m3-learning/Pulsed-Laser-Deposition-Multi-Target-Carousel-Controller/3d_models/Custom backplate/REAME.md

This custom panel replaces the back plate on the multi-target carousel controller.
