m3-learning/Pulsed-Laser-Deposition-Multi-Target-Carousel-Controller/3d_models/Custom backplate/Panel Weld Mount.pdf

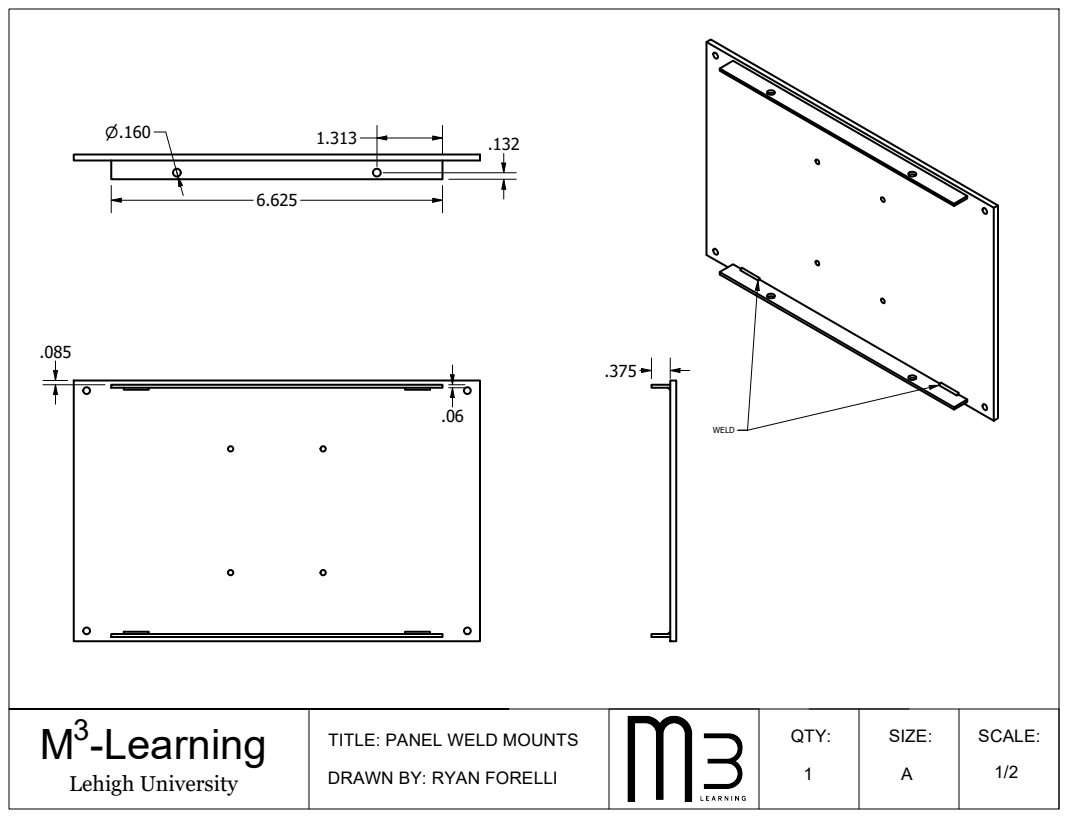
[picture p2: page 1]
Lehigh University

TITLE: PANEL WELD MOUNTS

DRAWN BY: RYAN FORELLI
