m3-learning/Pulsed-Laser-Deposition-Multi-Target-Carousel-Controller/schematics/PLD_Controller_Board/PLD Controller Board.brd

## EAGLE design schematics/PLD_Controller_Board/PLD Controller Board.brd (2021-06-27)

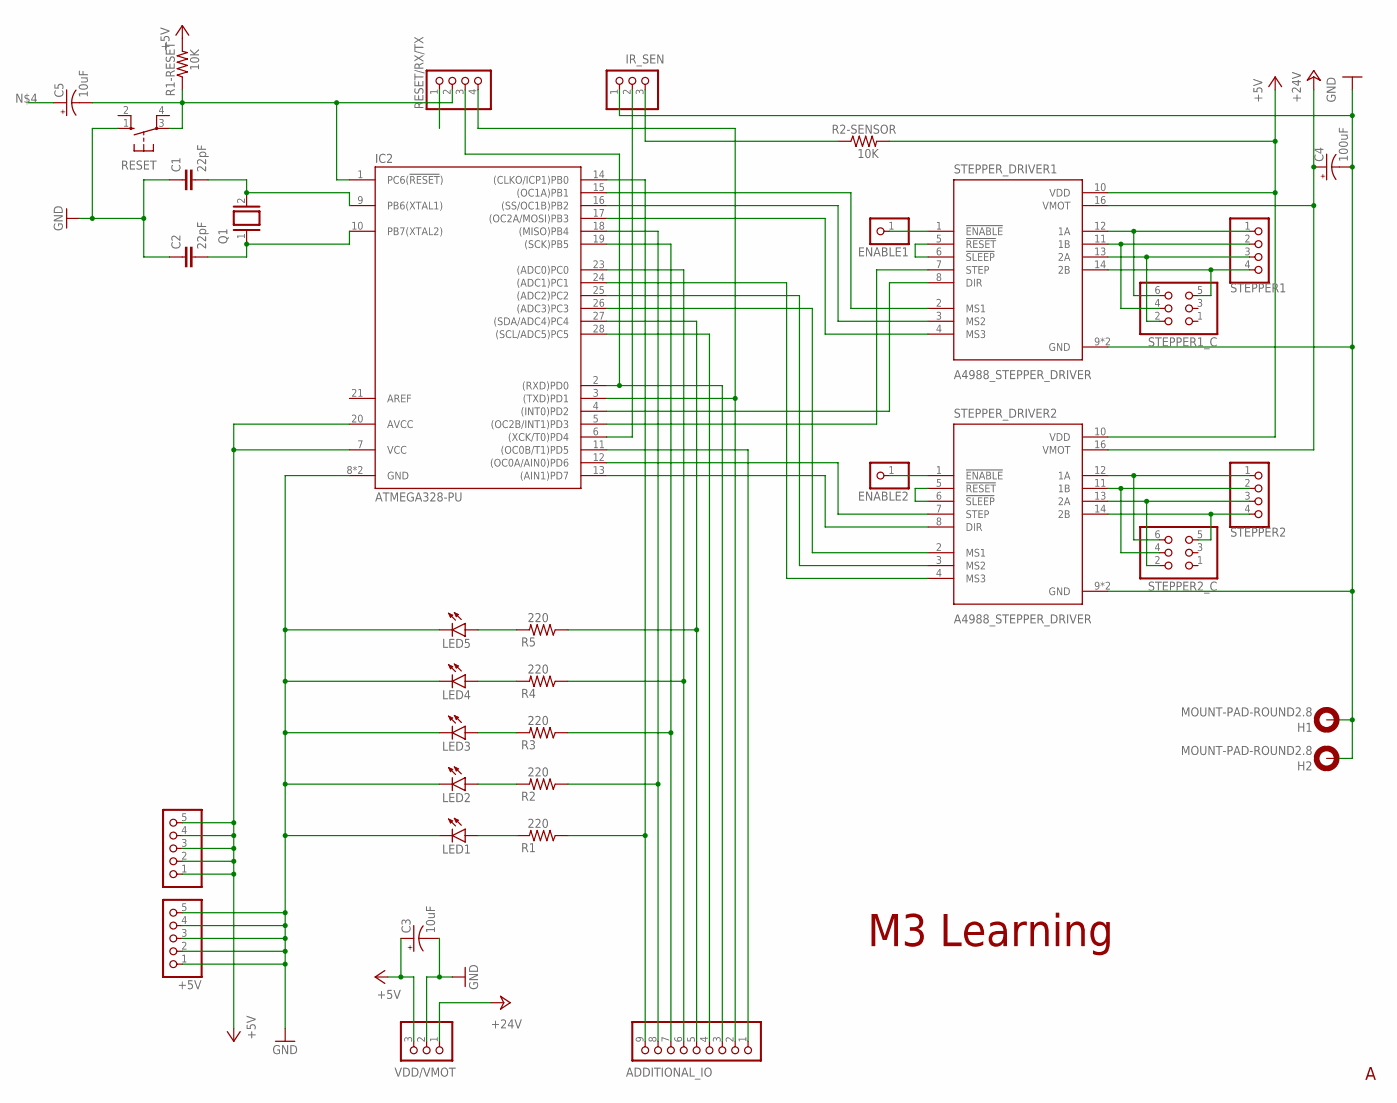
[picture p3: schematic PLD Controller Board.sch]

Parts:
+5V: PINHD-1X5; 1X05
ADDITIONAL_IO: PINHD-1X9; 1X09
C1, C2: 22pF; CAP-PTH-2.54
C3, C5: 10uF; CPOL-RADIAL-2.5MM-5MM
C4: 100uF; CPOL-RADIAL-2.5MM-5MM
ENABLE1, ENABLE2: PINHD-1X1; 1X01
GND: PINHD-1X5; 1X05
H1, H2: MOUNT-PAD-ROUND2.8; 2,8-PAD
IC2: ATMEGA328-PU; DIL28
IR_SEN: PINHD-1X3; 1X03
LED1, LED2, LED3, LED4, LED5: LED5MM
Q1: XTAL/S; QS
R1, R2, R3, R4, R5: 220; 0204/7
R1-RESET, R2-SENSOR: 10K; 0204/7
RESET: 10-XX; B3F-10XX
RESET/RX/TX: PINHD-1X4; 1X04
STEPPER1, STEPPER2: PINHD-1X4; 1X04
STEPPER1_C, STEPPER2_C: PINHD-2X3; 2X03
STEPPER_DRIVER1, STEPPER_DRIVER2: A4988_STEPPER_DRIVER; MODULE_A4988_STEPPER_MOTOR_DRIVER_CARRIER
VDD/VMOT: PINHD-1X3; 1X03

Connections:
+5V: C3.1 (+), GND.1, GND.2, GND.3, GND.4, GND.5, IC2.7 (VCC), IC2.20 (AVCC), R1-RESET.2, R2-SENSOR.2, STEPPER_DRIVER1.10 (VDD), STEPPER_DRIVER2.10 (VDD), VDD/VMOT.3
+24V: C4.1 (+), STEPPER_DRIVER1.16 (VMOT), STEPPER_DRIVER2.16 (VMOT), VDD/VMOT.1
GND: +5V.1, +5V.2, +5V.3, +5V.4, +5V.5, C1.1, C2.1, C3.2 (-), C4.2 (-), H1.B2,8, H2.B2,8, IC2.8 (GND), IC2.22 (GND), IR_SEN.1, LED1.K (C), LED2.K (C), LED3.K (C), LED4.K (C), LED5.K (C), RESET.1 (S), STEPPER_DRIVER1.9 (GND), STEPPER_DRIVER1.15 (GND), STEPPER_DRIVER2.9 (GND), STEPPER_DRIVER2.15 (GND), VDD/VMOT.2
unnamed: C5.2 (-), IC2.1 (PC6(!RESET!)), R1-RESET.1, RESET.3, RESET/RX/TX.2
unnamed: C1.2, IC2.9 (PB6(XTAL1)), Q1.2
unnamed: C2.2, IC2.10 (PB7(XTAL2)), Q1.1
unnamed: C5.1 (+), RESET/RX/TX.1
unnamed: STEPPER_DRIVER1.5 (!RESET), STEPPER_DRIVER1.6 (!SLEEP)
unnamed: STEPPER_DRIVER2.5 (!RESET), STEPPER_DRIVER2.6 (!SLEEP)
unnamed: IR_SEN.3, R2-SENSOR.1
unnamed: STEPPER1.2, STEPPER1_C.4, STEPPER_DRIVER1.11 (1B)
unnamed: STEPPER1.3, STEPPER1_C.2, STEPPER_DRIVER1.13 (2A)
unnamed: STEPPER1.4, STEPPER1_C.5, STEPPER_DRIVER1.14 (2B)
unnamed: STEPPER2.1, STEPPER2_C.6, STEPPER_DRIVER2.12 (1A)
unnamed: STEPPER2.2, STEPPER2_C.4, STEPPER_DRIVER2.11 (1B)
unnamed: STEPPER2.3, STEPPER2_C.2, STEPPER_DRIVER2.13 (2A)
unnamed: STEPPER2.4, STEPPER2_C.5, STEPPER_DRIVER2.14 (2B)
unnamed: ENABLE1.1, STEPPER_DRIVER1.1 (!ENABLE)
unnamed: ENABLE2.1, STEPPER_DRIVER2.1 (!ENABLE)
unnamed: LED4.A, R4.2
unnamed: LED3.A, R3.2
unnamed: LED2.A, R2.2
unnamed: LED1.A, R1.2
unnamed: IC2.4 ((INT0)PD2), STEPPER_DRIVER1.8 (DIR)
unnamed: IC2.5 ((OC2B/INT1)PD3), STEPPER_DRIVER1.7 (STEP)
unnamed: IC2.13 ((AIN1)PD7), STEPPER_DRIVER2.8 (DIR)
unnamed: IC2.12 ((OC0A/AIN0)PD6), STEPPER_DRIVER2.7 (STEP)
unnamed: IC2.15 ((OC1A)PB1), STEPPER_DRIVER1.2 (MS1)
unnamed: IC2.16 ((SS/OC1B)PB2), STEPPER_DRIVER1.3 (MS2)
unnamed: IC2.17 ((OC2A/MOSI)PB3), STEPPER_DRIVER1.4 (MS3)
unnamed: IC2.26 ((ADC3)PC3), STEPPER_DRIVER2.2 (MS1)
unnamed: IC2.25 ((ADC2)PC2), STEPPER_DRIVER2.3 (MS2)
unnamed: IC2.24 ((ADC1)PC1), STEPPER_DRIVER2.4 (MS3)
unnamed: IC2.6 ((XCK/T0)PD4), IR_SEN.2
unnamed: ADDITIONAL_IO.9, IC2.14 ((CLKO/ICP1)PB0), R1.1
unnamed: ADDITIONAL_IO.8, IC2.18 ((MISO)PB4), R2.1
unnamed: ADDITIONAL_IO.7, IC2.19 ((SCK)PB5), R3.1
unnamed: ADDITIONAL_IO.6, IC2.23 ((ADC0)PC0), R4.1
unnamed: ADDITIONAL_IO.5, IC2.27 ((SDA/ADC4)PC4), R5.1
unnamed: ADDITIONAL_IO.4, IC2.28 ((SCL/ADC5)PC5)
unnamed: ADDITIONAL_IO.3, IC2.2 ((RXD)PD0), RESET/RX/TX.3
unnamed: ADDITIONAL_IO.2, IC2.3 ((TXD)PD1), RESET/RX/TX.4
unnamed: ADDITIONAL_IO.1, IC2.11 ((OC0B/T1)PD5)
unnamed: LED5.A, R5.2
unnamed: STEPPER1.1, STEPPER1_C.6, STEPPER_DRIVER1.12 (1A)

Notes on the sheet:
M3 Learning

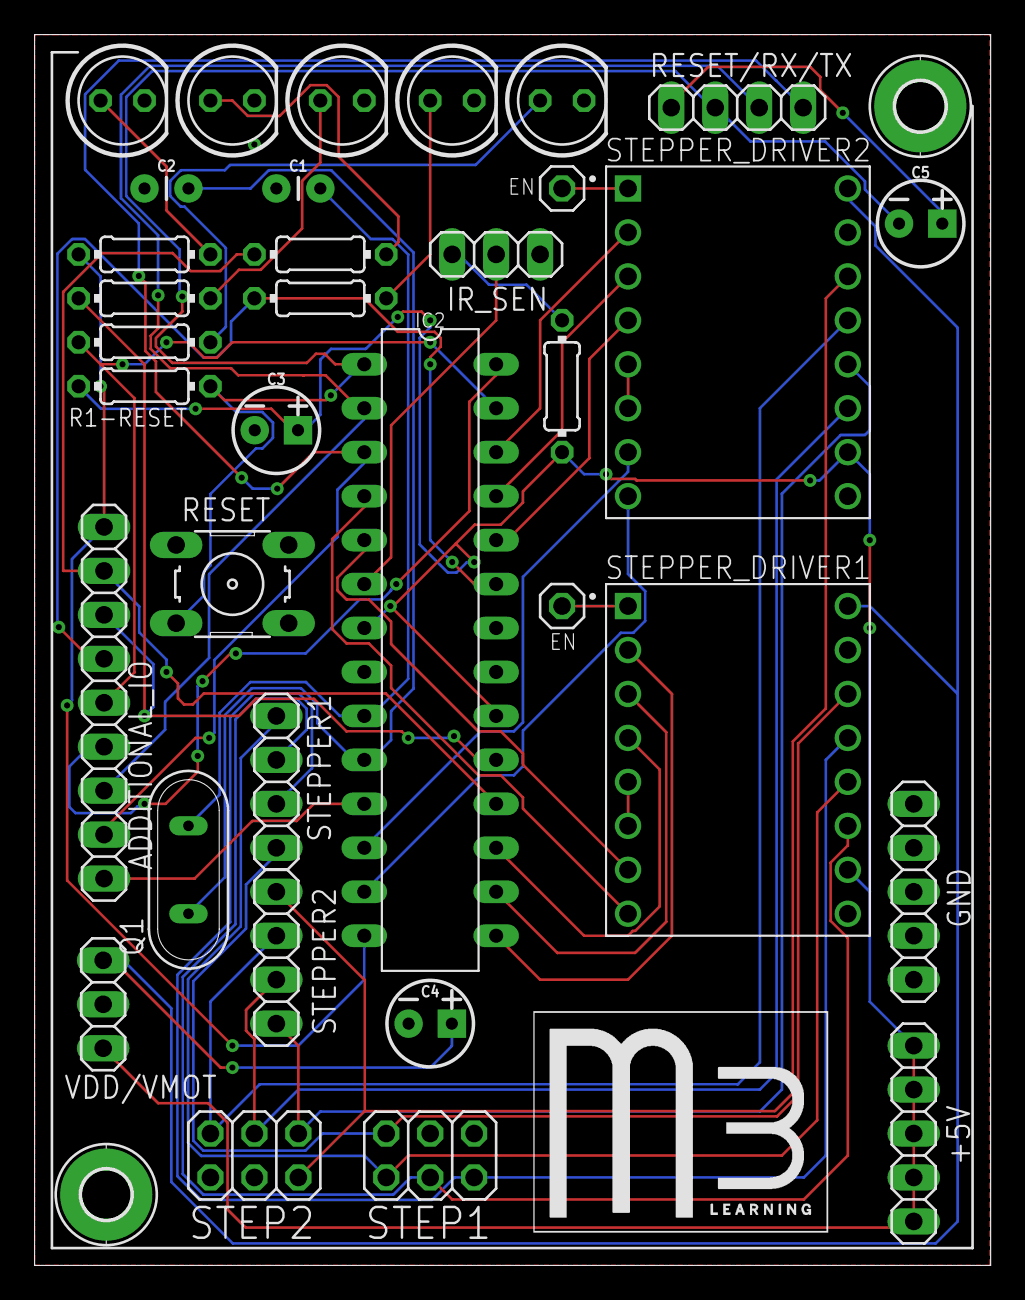
[picture p4: board PLD Controller Board.brd from above]

Board: 2 copper layers, 55.2 x 71.1 mm, 36 parts (0 on the bottom side), 45 nets.
