m3-learning/Pulsed-Laser-Deposition-Multi-Target-Carousel-Controller/(notices)

Notices in the files:
schematics/PLD_Controller_Board/PLD Controller Board.brd:
Released under BSD-3 License.
parts and their libraries:
SparkFun-Capacitors: Licensing: Creative Commons ShareAlike 4.0 International - https://creativecommons.org/licenses/by-sa/4.0
